Diogonac/Programacao-mini-estacao-meteorologica/README.md

Este código coleta dados de temperatura, luminosidade, pressão e umidade. Os dados coletados são exibidos em um display lcd.
